mikhailsdv/smart-traffic-light/(commit log)

2026-10-08 Fix Yandex token handling, add request timeouts and batch lamp updates
    - Fetch Yandex access token lazily with in-memory cache, shared refresh and one retry on 401
    - Send all lamps in one Yandex /devices/actions request via optional provider setState
    - Add AbortSignal timeouts to Tasmota and Yandex requests
    - Require application/json Content-Type in web server readJson (415 otherwise)
    - Introduce providerNames/isProviderName as single source of provider names
    - Fix exchange-code usage hint and remove dead wait() in heart command runner
    - Update AGENTS.md
    Claude-Session: https://claude.ai/code/session_01LEpR4LtYsrp3tV2RaWKghQ
2026-10-08 Validate Yandex action results and share IoT API client
    - Add requestYandexIot helper for token, 401 retry, timeout and top-level status checks
    - Fail on device- or capability-level action_result errors from /devices/actions
    - Reuse the helper in Yandex tools and dedupe OAuth token requests
    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
2026-10-08 Match Yandex action result check to documented response format
    - Drop undocumented device-level action_result handling
    - Treat missing devices or missing capability action_result as failures
    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
2026-10-08 Switch Tasmota relays together with a single Backlog0 command
    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
2026-10-08 Use YANDEX_REFRESH_TOKEN from env as the only persisted Yandex secret
    - Drop .tokens file cache; keep access token in memory only
    - exchange-code prints YANDEX_REFRESH_TOKEN for .env
    - Update README and AGENTS.md
    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
2026-10-08 Add hardware build guide with English wiring diagram
    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
2026-10-08 Add all lamps on/off buttons to web UI
    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
2026-10-08 Sync web UI with real lamp state from providers
    - Add optional getState() to providers: Tasmota State command, Yandex per-device state
    - /status reads state from the selected provider with shared in-flight reads
    - UI polls every 5s after the previous response and refreshes on provider switch
    - Ignore stale poll responses during toggles and provider changes
    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
2026-10-08 Split web UI action buttons into separate pills
    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
2026-10-08 Run traffic light scripts from the web UI
    - Pass an AbortSignal to scripts and make delay() abortable
    - Add WebScriptRunner with one running script at a time
    - Add /scripts/start and /scripts/stop; manual toggles stop the running script
    - Add script buttons with active state to the UI
    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
2026-10-08 Track script lamp state on server and follow it in the UI
    - Wrap the script provider to record every successful lamp change
    - Serve tracked state from /status while a script runs, without provider reads
    - Poll every second while a script runs and reschedule on script changes
    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
2026-10-08 Redesign web UI controls
    - Header with current mode and compact provider switch
    - Scenario cards with animated mini traffic lights and running badge
    - Prominent red stop button and separate all-lamps section
    - System dark theme, responsive lamp size and clearer hints
    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
2026-10-09 Update README for current scripts, web UI and VPS setup
    - Add a scenarios table with required env variables per script and provider
    - Describe the current web UI instead of the old floating switch
    - List traffic and air quality variables for VPS and explain how to change the Docker script
    - Add traffic and air quality setup sections with curl checks
    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
2026-10-25 Switch air quality from WAQI to IQAir
    Read US AQI from the IQAir AirVisual API. The location is set with an
    iqair.com city or station link (AIR_QUALITY_IQAIR_URL, /air-quality/ or
    /air-quality-map/) or with AIR_QUALITY_LAT/AIR_QUALITY_LON for the
    nearest city. Ignore .DS_Store files.
